Eliasjapi-dev/RobotiArm-Classifier/(notices)

Notices in the files:
README.md:
License: MIT
